JosephBrooksbank/kicad_library/README.md

## Third Party Libaries
> https://www.kicad.org/libraries/third_party/

### Digikey
https://github.com/Digi-Key/digikey-kicad-library
