JosephBrooksbank/kicad_library/models/DSQ0010A.stp

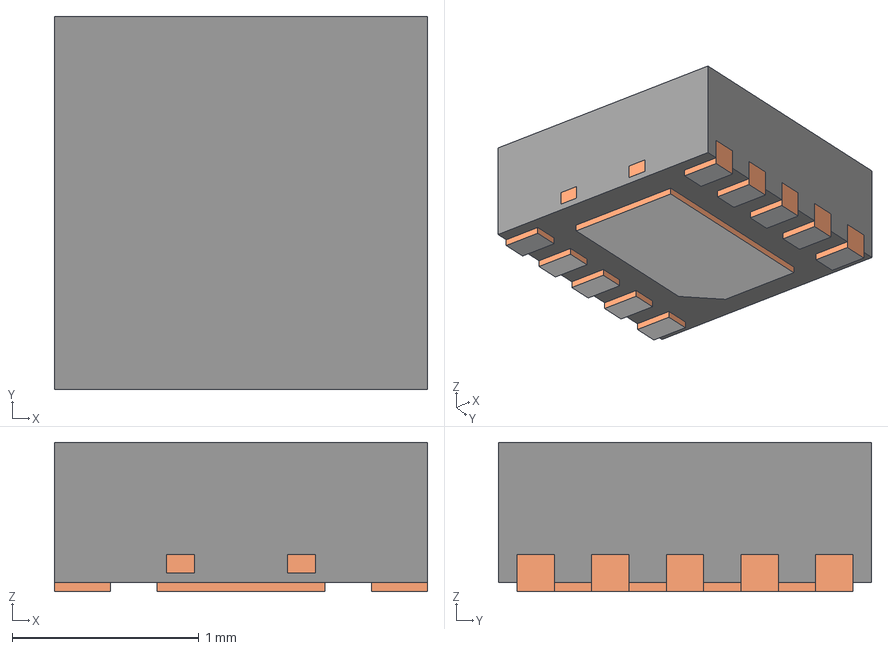
[picture p1: CAD file, 2025-04-25]
models/DSQ0010A.stp
2.00 x 2.00 x 0.8 mm
BODY-SON
FRAME-DSQ0010A
PIN1-ID
