JosephBrooksbank/kicad_library/models/EEF-CX0J151XR.STEP

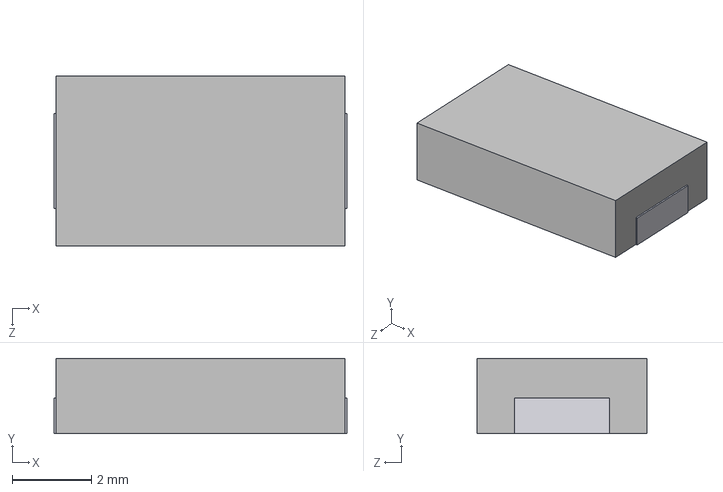
[picture p2: CAD file, 2025-04-25]
models/EEF-CX0J151XR.STEP
7.40 x 1.90 x 4.30 mm
