JosephBrooksbank/kicad_library/models/ECS-240-20-30B-TR.STEP

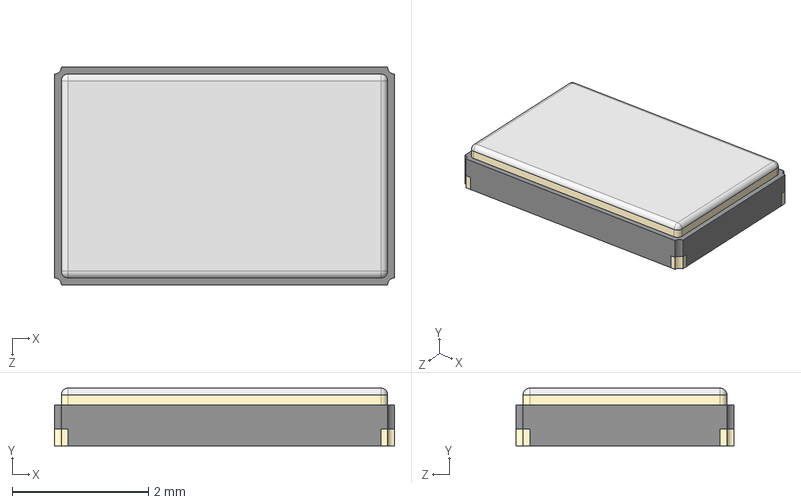
[picture p3: CAD file, 2025-04-01]
models/ECS-240-20-30B-TR.STEP
5.00 x 0.85 x 3.20 mm
