JosephBrooksbank/kicad_library/models/BEADC1608X95N.step

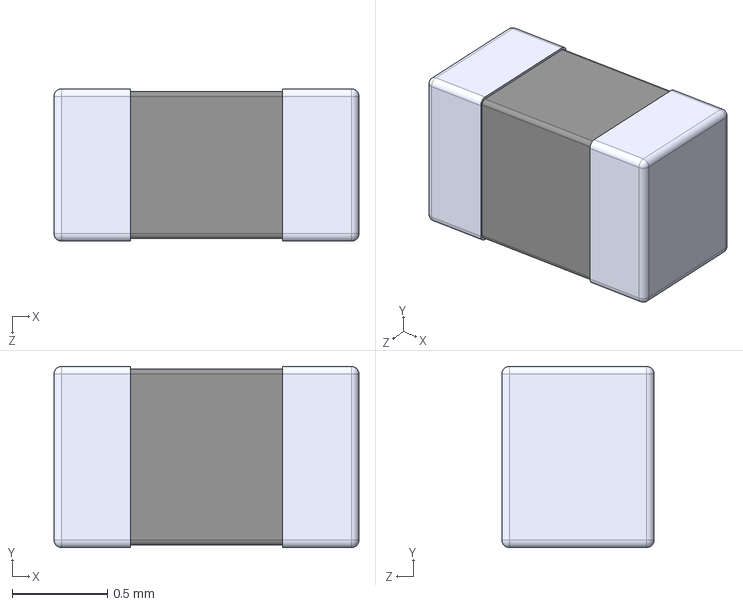
[picture p4: CAD file, 2025-04-01]
models/BEADC1608X95N.step
1.60 x 0.95 x 0.8 mm
