JosephBrooksbank/kicad_library/models/694108301002.step

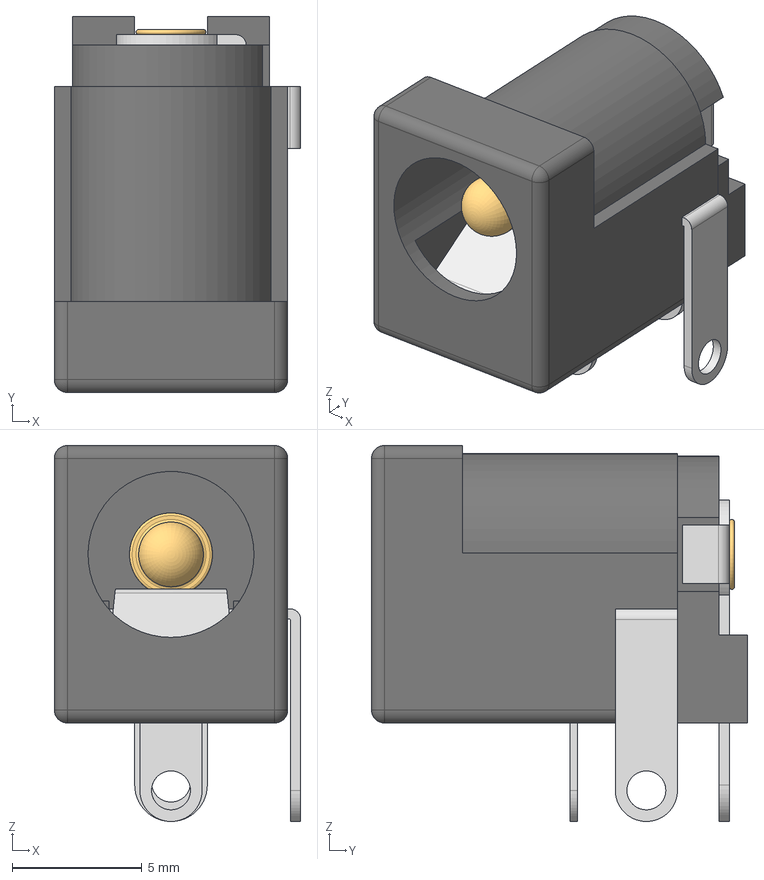
[picture p5: CAD file, 2025-04-01]
models/694108301002.step
9.50 x 14.5 x 14.5 mm
6941xx301002
694108301002_PinContact
6941xx301002_Back
6941xx301002_PinContact2
6941xx301002_PinLame
6941xx301002_PinBis
