JosephBrooksbank/kicad_library/models/61400416021.step

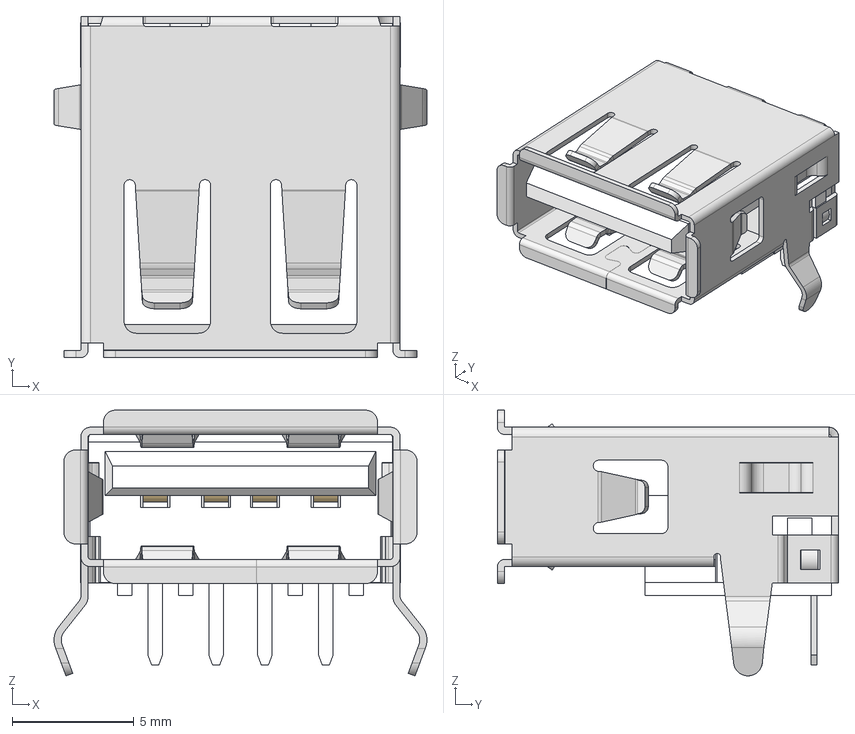
[picture p6: CAD file, 2025-04-01]
models/61400416021.step
15.3 x 14.0 x 10.9 mm
61400416021_Insulator
61400416021_Contact Plating x 4
61400416021_Shielding
