JosephBrooksbank/kicad_library/(commit log)

2025-03-31 updated footprints
2025-03-31 updated pin functions
2025-04-01 add symbols & footprints & models for usb hub components
    [61400416021.step, 694108301002.step, BEADC1608X95N.step, ECS-240-20-30B-TR.STEP]
2025-04-08 added footprints
2025-04-25 add TLV75102
    [DSQ0010A.stp, EEF-CX0J151XR.STEP]
